mcqn/nfc-st25r3916/README.md

# Vicino NFC/RFID Board

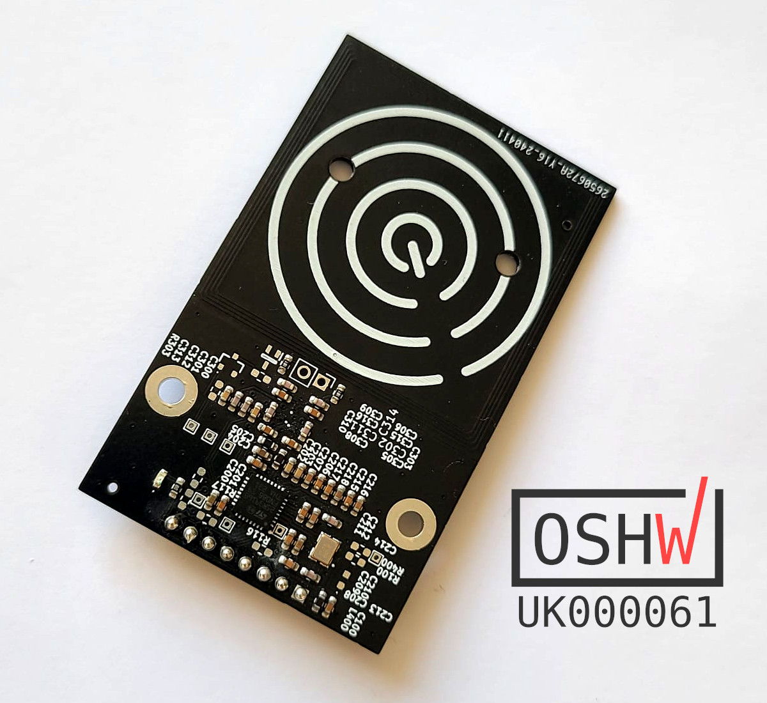
[picture p1: VICINO-Main-OSHW.jpg]
A black rectangular PCB with chips and components clustered in the bottom third. The rest of the board is an antenna, marked with concentric circles of white silkscreen


An RFID/NFC reader using the ST Microelectronics ST25R3916B chip.  Hardware available [from the MCQN Ltd. shop](https://www.tindie.com/products/mcqn_ltd/vicino/).

For using the board see the [Examples.md](Examples.md) page.
