mcqn/nfc-st25r3916/KiCad/cardboard/cardboard_bom.ods

Ref | Qty | Value | Cmp name | Footprint | Description | Mouser 20240116 order | Qty | Vendor links
U200, | 1 | ST25R3916B-AQWT | ST25R3916B-AQWT | QFN50P500X500X100-33N-D | NFC/RFID Tags & Transponders NFC reader for payment, consumer and industrial | https://www.mouser.co.uk/ProductDetail/511-ST25R3916B-AQWT | 5 | https://www.digikey.co.uk/en/products/detail/stmicroelectronics/ST25R3916B-AQWT/16516567
Y200, | 1 | NX3225SA-27.12M-STD-CSR-3 | NX3225SA-27.12M-STD-CSR-3 | Lol_20230821:NX3225SA12000MHZSTDCSR1 | Crystal SMD 3225 27.12MHz | https://www.mouser.co.uk/ProductDetail/344-NX3225SA27.12MST | 5 | https://www.mouser.co.uk/ProductDetail/NDK/NX3225SA-27.12M-STD-CSR-3?qs=w%2Fv1CP2dgqrycwpf4zbGAA%3D%3D | https://uk.farnell.com/samsung-electro-mechanics/cl10a225kq8nnnc/cap-2-2uf-6-3v-mlcc-0603/dp/3013394RL | Re-reel
C100, C207, C210, C212, C216, C218, | 6 | 2u2 | C | Lol_20230821:Lol_0603 | Unpolarized capacitor | https://www.mouser.co.uk/ProductDetail/Samsung-Electro-Mechanics/CL10A225KP8NNNC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 | 100 | https://uk.farnell.com/samsung-electro-mechanics/cl10a225kq8nnnc/cap-2-2uf-6-3v-mlcc-0603/dp/3013394 | https://uk.farnell.com/samsung-electro-mechanics/cl10a105ka8nnnc/cap-1uf-25v-mlcc-0603/dp/3010056
C200, | 1 | 1u | C | Lol_20230821:Lol_0603 | Unpolarized capacitor | https://www.mouser.co.uk/ProductDetail/KEMET/C0603C105K4RACTU?qs=STjISULpmtZNMAZGR4X39Q%3D%3D | 10 | https://uk.farnell.com/samsung-electro-mechanics/cl10a105ka8nnnc/cap-1uf-25v-mlcc-0603/dp/3013382 | https://uk.farnell.com/samsung-electro-mechanics/cl10b103kb8nnnc/cap-0-01uf-50v-mlcc-0603/dp/3010081 | Full reel 4000 £12
C201, C204, C206, C208, C209, C211, C215, C217, | 8 | 10n | C | Lol_20230821:Lol_0603 | Unpolarized capacitor | https://www.mouser.co.uk/ProductDetail/YAGEO/CC0603KRX7R9BB103?qs=AgBp2OyFlx%252BeoRRspw6PJg%3D%3D | 100 | https://uk.farnell.com/samsung-electro-mechanics/cl10b103kb8nnnc/cap-0-01uf-50v-mlcc-0603/dp/3013408
C202, | 1 | 1n | C | Lol_20230821:Lol_0603 | Unpolarized capacitor | https://www.mouser.co.uk/ProductDetail/KEMET/C0603C102J5RACTU?qs=qG1y%252BaZBm0ORyW8zMfKotw%3D%3D | 10 | https://uk.farnell.com/samsung-electro-mechanics/cl10c102jb8nnnc/cap-1000pf-50v-mlcc-0603/dp/3013440
C203, | 1 | 22n | C | Lol_20230821:Lol_0603 | Unpolarized capacitor | https://www.mouser.co.uk/ProductDetail/KEMET/C0603C223K5RACAUTO7411?qs=qbH48L%2FGONQMhVCNVaAS1Q%3D%3D | 10
C205, | 1 | 4u7 | C | Lol_20230821:Lol_0603 | Unpolarized capacitor | https://www.mouser.co.uk/ProductDetail/Samsung-Electro-Mechanics/CL10A475KP8NNNL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 | 10 | https://uk.farnell.com/samsung-electro-mechanics/cl10a225kq8nnnc/cap-2-2uf-6-3v-mlcc-0603/dp/3013394RL | Per order charge
C213, C214, C301, C312, | 4 | 10p | C | Lol_20230821:Lol_0603 | Unpolarized capacitor | https://www.mouser.co.uk/ProductDetail/Vishay-Vitramon/VJ0603A100GXACW1BC?qs=PdD6qrCyjkAydYW8ITawjw%3D%3D | 40 | https://uk.farnell.com/multicomp-pro/mc0603n100f500ct/ceramic-capacitor-10pf-50v-c0g/dp/1710160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 | https://uk.farnell.com/yageo/cc0603grnpo9bn181/cap-180pf-50v-mlcc-0603/dp/3764441RL | https://uk.farnell.com/multicomp-pro/mp0603n181g500ct/cap-180pf-50v-mlcc-0603/dp/4130254RL | https://uk.farnell.com/murata/gcm1885c2a181fa16d/cap-180pf-100v-mlcc-0603/dp/3784624 | https://uk.farnell.com/yageo/cc0603grnpo9bn181/cap-180pf-50v-mlcc-0603/dp/3759598 | https://uk.farnell.com/yageo/cc0603frnpo9bn181/cap-180pf-50v-mlcc-0603/dp/3759566
C305, C308, | 2 | 680p | C | Lol_20230821:Lol_0603 | Unpolarized capacitor | https://www.mouser.co.uk/ProductDetail/Samsung-Electro-Mechanics/CL10C681JB8NFNC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 | 20 | https://uk.farnell.com/murata/gcm1885c2a681fa16d/cap-aec-q200-680pf-100v-mlcc-0603/dp/3581272 | https://www.mouser.co.uk/ProductDetail/Murata-Electronics/LXRW0YV600-054?qs=ds50AKTGxA8D9pWE0AMokg%3D%3D
C302, C314, C311 | 3 | LXRW0YV600-054 | LXRW0YV600-054_Drawn | Lol_20230821:LXRW0YV600054 Handsolder | Trimmer / Variable Capacitors 50VAC 60pF CSP 0.6x0.6mm | https://www.mouser.co.uk/ProductDetail/Murata-Electronics/LXRW0YV600-054?qs=ds50AKTGxA8D9pWE0AMokg%3D%3D | 20 | https://uk.farnell.com/murata/lxrw0yv600-054/variable-capacitor-30-60pf-smd/dp/3052318 | https://uk.farnell.com/walsin/0603n101g500/capacitor-mlcc-100pf-c0g-50v-0603/dp/3790524 | https://uk.farnell.com/yageo/cc0603frnpo9bn101/cap-100pf-50v-mlcc-0603/dp/3759559
L300, L301, L400, | 3 | MLJ1608WR27JT000 | Lol_L | Lol_20230821:Lol_0603 |  | https://www.mouser.co.uk/ProductDetail/TDK/MLJ1608WR27JT000?qs=XFe3dyCRgQjWReJUSn7JRQ%3D%3D | 20 | https://uk.farnell.com/tdk/mlj1608wr27jt000/inductor-270nh-260mhz-shld-0603/dp/3386864?st=MLJ1608WR27JT000 | https://uk.farnell.com/murata/gcm1885c2a681ga16d/cap-aec-q200-680pf-100v-mlcc-0603/dp/3784366RL
LED100, LED101, | 2 | ~ | Lol_LED | MP008285 | LED, Red, SMD, 0603 [1608 Metric], 20 mA, 2.4 V, 638 nm |  |  |  | https://uk.farnell.com/walsin/0603n560g500ct/cap-56pf-50v-mlcc-0603/dp/3881041
R100, R101, | 2 | 1k | Lol_R | Lol_20230821:Lol_0603 | Resistor | https://www.mouser.co.uk/ProductDetail/YAGEO/AC0603FR-071KL | 20 | https://uk.farnell.com/multicomp-pro/mcwf06p1001ftl/res-thick-film-1k-1-0-125w-0603/dp/2694032
J411, | 1 | Conn_01x02_Pin | Conn_01x02_Pin | Connector_PinHeader_2.54mm:PinHeader_1x02_P2.54mm_Vertical | Generic connector, single row, 01x02, script generated |  |  |  | https://uk.farnell.com/vishay/vj0603a470gxacw1bc/cap-47pf-50v-2-c0g-np0-0603/dp/2896392 | https://uk.farnell.com/multicomp/mcmt18n470f100ct/cap-47pf-10v-1-c0g-np0-0603/dp/1856084RL
J412, | 1 | Conn_01x08_Pin | Conn_01x08_Pin | Connector_PinHeader_2.54mm:PinHeader_1x08_P2.54mm_Vertical | Generic connector, single row, 01x08, script generated
YELLOW = Needs to be specified after after antenna measurement
R300, R302, | 2 | 2R4 | Lol_R | Lol_20230821:Lol_0603 | Resistor | https://www.mouser.co.uk/ProductDetail/ROHM-Semiconductor/SDR03EZPJ2R4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 | 20 | https://uk.farnell.com/walsin/wr06w2r40ftl/res-2r4-1-0-1w-0603-thick-film/dp/2668257
C300, C313, | 2 | 180p | C | Lol_20230821:Lol_0603 | Unpolarized capacitor | https://www.mouser.co.uk/ProductDetail/YAGEO/CC0603GRNPO9BN181?qs=7s%252B3O6pAiyAu%252BAHaaNvB1w%3D%3D | 20 | https://uk.farnell.com/walsin/0603n181g500ct/cap-180pf-50v-mlcc-0603/dp/3881033
C303, C310, | 2 | 100p | C | Lol_20230821:Lol_0603 | Unpolarized capacitor | https://www.mouser.co.uk/ProductDetail/KEMET/C0603C101G1HACTU?qs=W0yvOO0ixfHBevHwATrgTQ%3D%3D | 20 | https://uk.farnell.com/walsin/0603n101f500ct/cap-100pf-50v-mlcc-0603/dp/3881026
C306, C309, | 2 | 56p | C | Lol_20230821:Lol_0603 | Unpolarized capacitor | https://www.mouser.co.uk/ProductDetail/Walsin/0603N560F500CT?qs=ZrPdAQfJ6DOrm8xCUHxE5Q%3D%3D | 20 | https://uk.farnell.com/murata/gcm1885c2a560fa16d/cap-aec-q200-56pf-100v-mlcc-0603/dp/3581267
C315, C316, | 2 | 82p | C | Lol_20230821:Lol_0603 | Unpolarized capacitor | https://www.mouser.co.uk/ProductDetail/Walsin/HH18N820G500CT?qs=ZrPdAQfJ6DO5GXvCW23E%252Bw%3D%3D | 20 | https://uk.farnell.com/yageo/cc0603frnpo9bn820/cap-82pf-50v-mlcc-0603/dp/3764431
RED = Do Not Fit
D300, | 1 | BAV70W-7-F | BAV70W-7-F | SOT65P210X100-3N | Diodes Inc 75V 300mA, Dual Silicon Junction Diode, 3-Pin SOT-323 BAV70W-7-F |  |  | https://uk.farnell.com/diodes-inc/bav70w-7-f/diode-small-signal-75v-0-3a-sot/dp/3127228?st=bav70w-7-f | https://www.mouser.co.uk/ProductDetail/Diodes-Incorporated/BAV70W-7-F?qs=1PNjYYN%2FHq3Y%2FR1jDefEWg%3D%3D
J300_1, J300_2, | 2 | Conn_01x01_Female | TestPoint_TH_Square | Lol_20230821:TestPoint_THTPad_1.0x1.0mm_Drill0.5mm | Generic connector, single row, 01x01, script generated (kicad-library-utils/schlib/autogen/connector/)
J400, J401, J402, J403, J406, J407, J408, | 7 | Conn_01x01_Female | TestPoint_TH_Square | Lol_20230821:TestPoint_THTPad_1.0x1.0mm_Drill0.5mm | Generic connector, single row, 01x01, script generated (kicad-library-utils/schlib/autogen/connector/)
P200, P202, | 2 | U.FL-R-SMT-1_10_ | Lol_U.FL | Lol_20230821:U.FL-R-SMT-1_10_ | UFL SMT PCB receptable,DC-6GHz Hirose Straight 50 Surface Mount UFL Connector, Receptacle, Solder Termination Coaxial | https://www.mouser.co.uk/ProductDetail/Hirose-Connector/U.FL-R-SMT-110?qs=kL1ClTr6oBoOdtqlGQpQrQ%3D%3D | 3 | https://uk.farnell.com/hirose-hrs/u-fl-r-smt-1-10/rf-coaxial-u-fl-straight-jack/dp/1688077
Q300, | 1 | NX3008NBK,215 | NX3008NBK,215 | NX3008NBK215 | NEXPERIA - NX3008NBK,215 - MOSFET Transistor, Trench, N Channel, 400 mA, 30 V, 1 ohm, 4.5 V, 900 mV |  |  | https://uk.farnell.com/nexperia/nx3008nbk-215/mosfet-n-ch-30v-400ma-sot23/dp/2069541?st=nx3008nbk
R116, R117, | 2 | 1k8 NF | Lol_R | Lol_20230821:Lol_0603 | Resistor |  |  | https://uk.farnell.com/te-connectivity/crgh0603f1k8/res-1k8-1-0-2w-0603-thick-film/dp/2332006
R204, | 1 | NF | Lol_R | Lol_20230821:Lol_0603 | Resistor |  |  |  | https://www.mouser.co.uk/ProductDetail/STMicroelectronics/ST25R3916B-AQWT?qs=Znm5pLBrcAK6gbJpvnT4Gw%3D%3D | https://uk.farnell.com/stmicroelectronics/st25r3916b-aqwt/rfid-read-write-27-12mhz-vfqfpn/dp/4067510
R205, R400, | 2 | NetTie_2 | TestPoint_Link_0603 | Lol_20230821:Lol_0603_tie | Breakin test point 0603 |  |  |  | https://uk.rs-online.com/web/p/crystal-units/1847880 | https://jlcpcb.com/partdetail/Ndk-NX3225SA_27_12M_STD_CSR3/C1987076 |  |  |  | https://www.mouser.co.uk/ProductDetail/NDK/NX3225SA-27.12M-STD-CSR-3?qs=w%2Fv1CP2dgqrycwpf4zbGAA%3D%3D
R301, | 1 | 100R | Lol_R | Lol_20230821:Lol_0603 | Resistor |  |  | https://uk.farnell.com/multicomp/mcwf06p1000ftl/res-100r-1-0-125w-0603-thick-film/dp/2694031
R303, | 1 | 47k | Lol_R | Lol_20230821:Lol_0603 | Resistor |  |  | https://uk.farnell.com/multicomp/mcwr06x4702ftl/res-47k-1-0-1w-thick-film/dp/2447376
H2,H1 | 2 | MountingHole_Pad | MountingHole_3.2mm_M3_Pad
H4,H3 | 2 | MountingHole NC | MountingHole_3.2mm_M3_Pad NPTH
