mcqn/nfc-st25r3916/tuning-test-data/39pF-1R5-33pF-acrylic-enclosure-tuning-scan.csv

aat_a | aat_b | amplitude
0 | 0 | 99
0 | 8 | 99
0 | 16 | 100
0 | 24 | 100
0 | 32 | 99
0 | 40 | 99
0 | 48 | 98
0 | 56 | 97
0 | 64 | 96
0 | 72 | 94
0 | 80 | 93
0 | 88 | 90
0 | 96 | 88
0 | 104 | 85
0 | 112 | 82
0 | 120 | 79
0 | 128 | 77
0 | 136 | 74
0 | 144 | 71
0 | 152 | 68
0 | 160 | 65
0 | 168 | 63
0 | 176 | 60
0 | 184 | 58
0 | 192 | 56
0 | 200 | 54
0 | 208 | 52
0 | 216 | 50
0 | 224 | 49
0 | 232 | 47
0 | 240 | 46
0 | 248 | 44
8 | 0 | 100
8 | 8 | 100
8 | 16 | 100
8 | 24 | 100
8 | 32 | 100
8 | 40 | 100
8 | 48 | 99
8 | 56 | 98
8 | 64 | 97
8 | 72 | 95
8 | 80 | 93
8 | 88 | 91
8 | 96 | 88
8 | 104 | 86
8 | 112 | 83
8 | 120 | 80
8 | 128 | 77
8 | 136 | 74
8 | 144 | 72
8 | 152 | 69
8 | 160 | 66
8 | 168 | 64
8 | 176 | 61
8 | 184 | 59
8 | 192 | 57
8 | 200 | 55
8 | 208 | 53
8 | 216 | 51
8 | 224 | 50
8 | 232 | 48
8 | 240 | 47
8 | 248 | 45
16 | 0 | 100
16 | 8 | 100
16 | 16 | 101
16 | 24 | 101
16 | 32 | 101
16 | 40 | 101
16 | 48 | 100
16 | 56 | 99
16 | 64 | 98
16 | 72 | 96
16 | 80 | 94
16 | 88 | 92
16 | 96 | 90
16 | 104 | 87
16 | 112 | 85
16 | 120 | 82
16 | 128 | 79
16 | 136 | 76
16 | 144 | 73
16 | 152 | 70
16 | 160 | 68
16 | 168 | 65
16 | 176 | 63
16 | 184 | 60
16 | 192 | 58
16 | 200 | 56
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
