mcqn/nfc-st25r3916/tuning-test-data/39pF-1R5-33pF-free-air-tuning-scan.csv

aat_a | aat_b | amplitude
0 | 0 | 98
0 | 8 | 98
0 | 16 | 98
0 | 24 | 98
0 | 32 | 98
0 | 40 | 98
0 | 48 | 97
0 | 56 | 96
0 | 64 | 95
0 | 72 | 93
0 | 80 | 91
0 | 88 | 89
0 | 96 | 86
0 | 104 | 84
0 | 112 | 81
0 | 120 | 78
0 | 128 | 75
0 | 136 | 72
0 | 144 | 69
0 | 152 | 67
0 | 160 | 64
0 | 168 | 62
0 | 176 | 59
0 | 184 | 57
0 | 192 | 55
0 | 200 | 53
0 | 208 | 51
0 | 216 | 50
0 | 224 | 48
0 | 232 | 46
0 | 240 | 45
0 | 248 | 44
8 | 0 | 99
8 | 8 | 99
8 | 16 | 99
8 | 24 | 99
8 | 32 | 99
8 | 40 | 99
8 | 48 | 98
8 | 56 | 97
8 | 64 | 95
8 | 72 | 94
8 | 80 | 92
8 | 88 | 90
8 | 96 | 87
8 | 104 | 85
8 | 112 | 82
8 | 120 | 79
8 | 128 | 76
8 | 136 | 73
8 | 144 | 70
8 | 152 | 68
8 | 160 | 65
8 | 168 | 63
8 | 176 | 61
8 | 184 | 58
8 | 192 | 56
8 | 200 | 54
8 | 208 | 52
8 | 216 | 51
8 | 224 | 49
8 | 232 | 47
8 | 240 | 46
8 | 248 | 45
16 | 0 | 99
16 | 8 | 99
16 | 16 | 100
16 | 24 | 100
16 | 32 | 100
16 | 40 | 100
16 | 48 | 99
16 | 56 | 98
16 | 64 | 97
16 | 72 | 95
16 | 80 | 93
16 | 88 | 91
16 | 96 | 89
16 | 104 | 86
16 | 112 | 83
16 | 120 | 80
16 | 128 | 78
16 | 136 | 75
16 | 144 | 72
16 | 152 | 69
16 | 160 | 67
16 | 168 | 64
16 | 176 | 62
16 | 184 | 60
16 | 192 | 58
16 | 200 | 55
16 | 208 | 54
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
