mcqn/nfc-st25r3916/tuning-test-data/39pF-1R5-acrylic-enclosure-tuning-scan.csv

aat_a | aat_b | amplitude
0 | 0 | 91
0 | 8 | 91
0 | 16 | 92
0 | 24 | 93
0 | 32 | 94
0 | 40 | 96
0 | 48 | 97
0 | 56 | 98
0 | 64 | 99
0 | 72 | 100
0 | 80 | 101
0 | 88 | 101
0 | 96 | 102
0 | 104 | 102
0 | 112 | 102
0 | 120 | 101
0 | 128 | 101
0 | 136 | 100
0 | 144 | 98
0 | 152 | 96
0 | 160 | 94
0 | 168 | 90
0 | 176 | 86
0 | 184 | 82
0 | 192 | 78
0 | 200 | 74
0 | 208 | 71
0 | 216 | 67
0 | 224 | 65
0 | 232 | 62
0 | 240 | 60
0 | 248 | 57
8 | 0 | 90
8 | 8 | 91
8 | 16 | 92
8 | 24 | 93
8 | 32 | 94
8 | 40 | 96
8 | 48 | 97
8 | 56 | 98
8 | 64 | 99
8 | 72 | 100
8 | 80 | 101
8 | 88 | 101
8 | 96 | 102
8 | 104 | 102
8 | 112 | 102
8 | 120 | 101
8 | 128 | 101
8 | 136 | 100
8 | 144 | 98
8 | 152 | 96
8 | 160 | 94
8 | 168 | 90
8 | 176 | 87
8 | 184 | 83
8 | 192 | 79
8 | 200 | 75
8 | 208 | 71
8 | 216 | 68
8 | 224 | 65
8 | 232 | 62
8 | 240 | 60
8 | 248 | 58
16 | 0 | 90
16 | 8 | 90
16 | 16 | 91
16 | 24 | 93
16 | 32 | 94
16 | 40 | 95
16 | 48 | 96
16 | 56 | 98
16 | 64 | 99
16 | 72 | 100
16 | 80 | 100
16 | 88 | 101
16 | 96 | 101
16 | 104 | 102
16 | 112 | 102
16 | 120 | 101
16 | 128 | 101
16 | 136 | 100
16 | 144 | 99
16 | 152 | 97
16 | 160 | 94
16 | 168 | 91
16 | 176 | 87
16 | 184 | 83
16 | 192 | 79
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
