mcqn/nfc-st25r3916/tuning-test-data/39pF-1R5-free-air-tuning-scan.csv

aat_a | aat_b | amplitude
0 | 0 | 89
0 | 8 | 90
0 | 16 | 91
0 | 24 | 92
0 | 32 | 93
0 | 40 | 95
0 | 48 | 96
0 | 56 | 97
0 | 64 | 98
0 | 72 | 99
0 | 80 | 100
0 | 88 | 101
0 | 96 | 101
0 | 104 | 101
0 | 112 | 101
0 | 120 | 101
0 | 128 | 100
0 | 136 | 99
0 | 144 | 97
0 | 152 | 95
0 | 160 | 92
0 | 168 | 88
0 | 176 | 84
0 | 184 | 80
0 | 192 | 76
0 | 200 | 72
0 | 208 | 69
0 | 216 | 66
0 | 224 | 63
0 | 232 | 61
0 | 240 | 58
0 | 248 | 56
8 | 0 | 89
8 | 8 | 90
8 | 16 | 91
8 | 24 | 92
8 | 32 | 93
8 | 40 | 95
8 | 48 | 96
8 | 56 | 97
8 | 64 | 98
8 | 72 | 99
8 | 80 | 100
8 | 88 | 101
8 | 96 | 101
8 | 104 | 101
8 | 112 | 101
8 | 120 | 101
8 | 128 | 100
8 | 136 | 99
8 | 144 | 97
8 | 152 | 95
8 | 160 | 92
8 | 168 | 88
8 | 176 | 84
8 | 184 | 80
8 | 192 | 76
8 | 200 | 73
8 | 208 | 69
8 | 216 | 66
8 | 224 | 64
8 | 232 | 61
8 | 240 | 59
8 | 248 | 57
16 | 0 | 88
16 | 8 | 89
16 | 16 | 90
16 | 24 | 92
16 | 32 | 93
16 | 40 | 94
16 | 48 | 96
16 | 56 | 97
16 | 64 | 98
16 | 72 | 99
16 | 80 | 100
16 | 88 | 101
16 | 96 | 101
16 | 104 | 101
16 | 112 | 101
16 | 120 | 101
16 | 128 | 100
16 | 136 | 99
16 | 144 | 97
16 | 152 | 95
16 | 160 | 92
16 | 168 | 88
16 | 176 | 85
16 | 184 | 81
16 | 192 | 77
16 | 200 | 73
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
