mcqn/nfc-st25r3916/tuning-test-data/47pF-1R5-33pF-acrylic-enclosure-tuning-scan.csv

aat_a | aat_b | amplitude
0 | 0 | 55
0 | 8 | 56
0 | 16 | 57
0 | 24 | 58
0 | 32 | 60
0 | 40 | 63
0 | 48 | 66
0 | 56 | 70
0 | 64 | 75
0 | 72 | 81
0 | 80 | 88
0 | 88 | 94
0 | 96 | 98
0 | 104 | 102
0 | 112 | 104
0 | 120 | 105
0 | 128 | 104
0 | 136 | 103
0 | 144 | 101
0 | 152 | 99
0 | 160 | 96
0 | 168 | 93
0 | 176 | 91
0 | 184 | 87
0 | 192 | 85
0 | 200 | 81
0 | 208 | 79
0 | 216 | 75
0 | 224 | 73
0 | 232 | 70
0 | 240 | 68
0 | 248 | 65
8 | 0 | 54
8 | 8 | 55
8 | 16 | 57
8 | 24 | 58
8 | 32 | 60
8 | 40 | 63
8 | 48 | 66
8 | 56 | 70
8 | 64 | 75
8 | 72 | 81
8 | 80 | 88
8 | 88 | 94
8 | 96 | 100
8 | 104 | 103
8 | 112 | 105
8 | 120 | 105
8 | 128 | 105
8 | 136 | 104
8 | 144 | 102
8 | 152 | 100
8 | 160 | 97
8 | 168 | 95
8 | 176 | 92
8 | 184 | 89
8 | 192 | 86
8 | 200 | 83
8 | 208 | 80
8 | 216 | 77
8 | 224 | 74
8 | 232 | 72
8 | 240 | 69
8 | 248 | 67
16 | 0 | 54
16 | 8 | 55
16 | 16 | 56
16 | 24 | 58
16 | 32 | 60
16 | 40 | 62
16 | 48 | 66
16 | 56 | 69
16 | 64 | 74
16 | 72 | 80
16 | 80 | 86
16 | 88 | 93
16 | 96 | 99
16 | 104 | 103
16 | 112 | 105
16 | 120 | 106
16 | 128 | 106
16 | 136 | 105
16 | 144 | 103
16 | 152 | 101
16 | 160 | 99
16 | 168 | 96
16 | 176 | 93
16 | 184 | 90
16 | 192 | 87
16 | 200 | 85
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
