mcqn/nfc-st25r3916/tuning-test-data/47pF-1R5-33pF-free-air-tuning-scan.csv

aat_a | aat_b | amplitude
0 | 0 | 48
0 | 8 | 48
0 | 16 | 49
0 | 24 | 49
0 | 32 | 50
0 | 40 | 52
0 | 48 | 53
0 | 56 | 55
0 | 64 | 57
0 | 72 | 60
0 | 80 | 62
0 | 88 | 65
0 | 96 | 68
0 | 104 | 71
0 | 112 | 74
0 | 120 | 78
0 | 128 | 81
0 | 136 | 84
0 | 144 | 87
0 | 152 | 90
0 | 160 | 92
0 | 168 | 95
0 | 176 | 97
0 | 184 | 98
0 | 192 | 100
0 | 200 | 101
0 | 208 | 102
0 | 216 | 103
0 | 224 | 104
0 | 232 | 104
0 | 240 | 105
0 | 248 | 105
8 | 0 | 47
8 | 8 | 48
8 | 16 | 48
8 | 24 | 49
8 | 32 | 50
8 | 40 | 52
8 | 48 | 53
8 | 56 | 55
8 | 64 | 57
8 | 72 | 60
8 | 80 | 62
8 | 88 | 65
8 | 96 | 68
8 | 104 | 71
8 | 112 | 74
8 | 120 | 78
8 | 128 | 81
8 | 136 | 84
8 | 144 | 88
8 | 152 | 90
8 | 160 | 93
8 | 168 | 95
8 | 176 | 97
8 | 184 | 99
8 | 192 | 100
8 | 200 | 101
8 | 208 | 102
8 | 216 | 103
8 | 224 | 104
8 | 232 | 104
8 | 240 | 105
8 | 248 | 105
16 | 0 | 47
16 | 8 | 48
16 | 16 | 48
16 | 24 | 49
16 | 32 | 50
16 | 40 | 51
16 | 48 | 53
16 | 56 | 55
16 | 64 | 57
16 | 72 | 59
16 | 80 | 62
16 | 88 | 64
16 | 96 | 67
16 | 104 | 71
16 | 112 | 74
16 | 120 | 77
16 | 128 | 81
16 | 136 | 84
16 | 144 | 87
16 | 152 | 90
16 | 160 | 92
16 | 168 | 95
16 | 176 | 97
16 | 184 | 98
16 | 192 | 100
16 | 200 | 101
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
