mcqn/nfc-st25r3916/tuning-test-data/39pF-1R5-33pF-acrylic-enclosure-tuning-scan.png

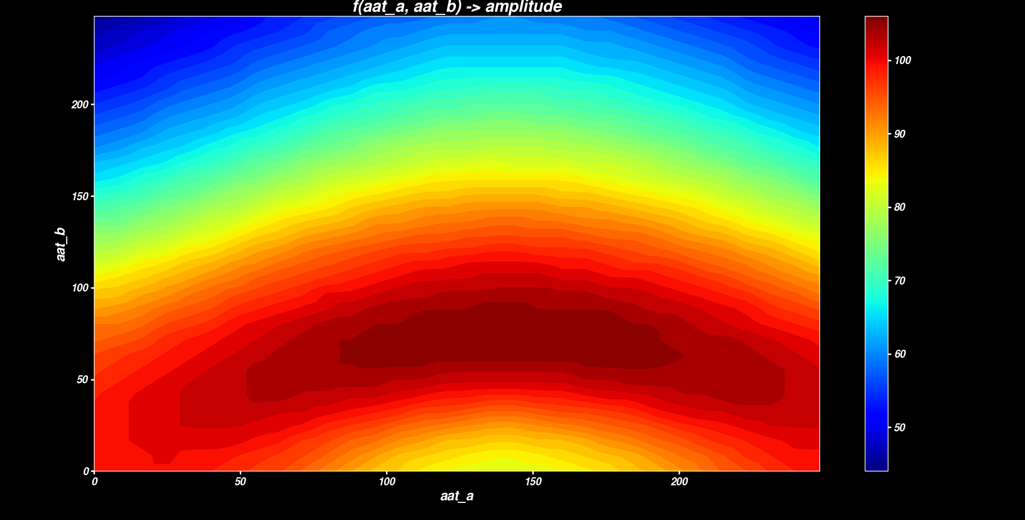
tuning-test-data/39pF-1R5-33pF-acrylic-enclosure-tuning-scan.png
