mcqn/nfc-st25r3916/tuning-test-data/47pF-1R5-33pF-free-air-tuning-scan.png

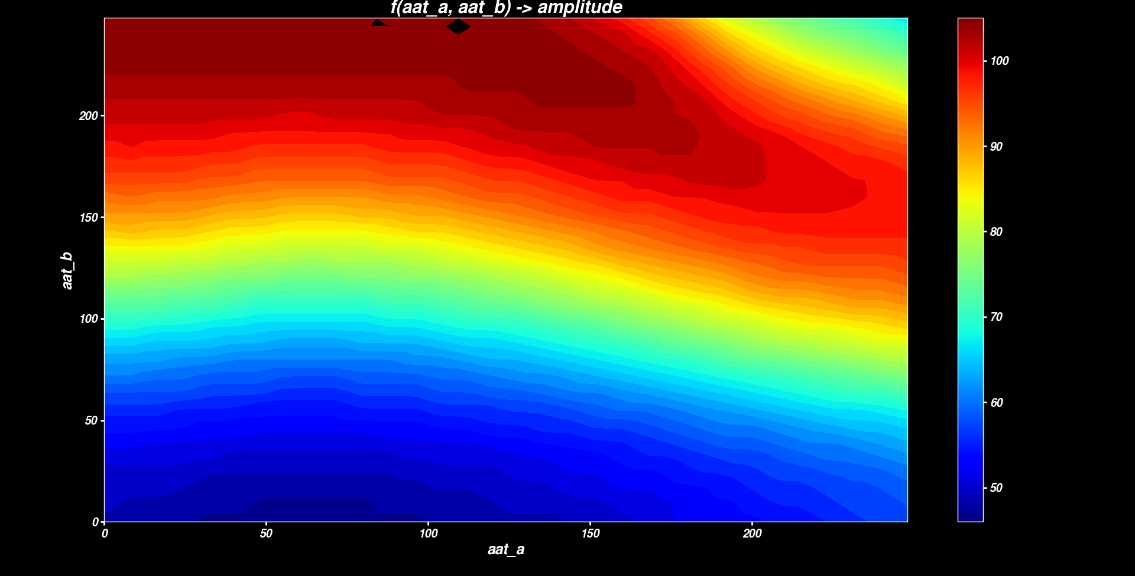
tuning-test-data/47pF-1R5-33pF-free-air-tuning-scan.png
