mcqn/nfc-st25r3916/tuning-test-data/47pF-2R4-acrylic-enclosure-tuning-scan.png

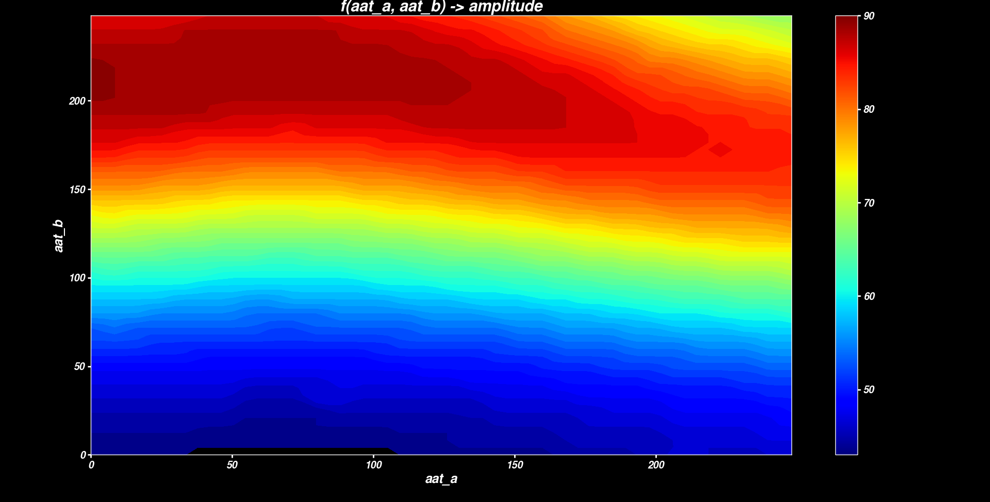
tuning-test-data/47pF-2R4-acrylic-enclosure-tuning-scan.png
