mcqn/nfc-st25r3916/(threads)

Thread 1 (2023-11-29):

Initial design of reader

amcewen, 2023-11-29:
The initial use of this reader will be as a replacement for the RC522 reader currently used by [Museum in a Box](https://museuminabox.org).

Key features:
* An LED on the top, which illuminates when a card is detected.  This will need to be controlled by whatever is connected to the reader, so effectively it's an LED controlled by a GPIO on the 8-way connector.
* An 8-way 0.1" pitch header on the underside for connection to the main board.  Through-hole I think.
* 4 mounting holes (3.2mm diameter)

Here's a rough guide to where things sit above the Museum in a Box PCB:

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

For the 8-way header, from left-to-right as seen in that image above (the red component footprint is the surface-mount 0.1" header) it would be good if we can keep to this pin-out: `3V3`, `IRQ`, `GND`, `LED`, `MISO`, `MOSI`, `SCLK`, `CS`

huffeec, 2024-03-14:
Closed with 4cfd301

Closed 2024-03-14.

Thread 4 (2024-01-31):

Initial bring-up and tuning

amcewen, 2024-01-31:
With a couple of boards fabbed we're onto bring-up and tuning of the antenna.

Initial key capacitor and resistor values are:
* C303 = C310 = 22pF
* C306 = C309 = 15pF
* C300 = C313 = 220pF
* C315 = C316 = 150pF
* R300 = R302 = 2R4

huffeec, 2024-03-14:
Closed with 4cfd301

Closed 2024-03-14.

Thread 6 (2024-03-13):

Apply for OSHW certification

huffeec, 2024-03-13:
Follow the process used in the [My Baby's got LED application](https://github.com/mcqn/my-babys-got-led/issues/9) to receive OSHW registration for this board.

My Baby's got LED is licenced as [CERN-OHL-S v2.0 ](https://cern-ohl.web.cern.ch/) is this applicable to this hardware too?

The libraries referenced in the documentation are covered by [STMicroelectronics](https://github.com/mcqn/NFC-RFAL/blob/main/LICENSE) but are not software included in this application. I think we are applying as 'No software' here?

The documentation for MBGL is licenced as [[CC BY-SA 4.0](http://creativecommons.org/licenses/by-sa/4.0/)]

#### We will need a name, version number and description for the application.

Eg "An RFID/NFC reader using the ST Microelectronics ST25R3916 chip. The board gives access via a header to power/gnd, four SPI pins, irq and a status led. The development and documentation for the board is available on github, and the board is manufactured by mcqn and sold on Tindie."

Should this include more detail, eg of modes available?

Tasks required to submit application to OSHW

- [x] Assign ibal number and add to catalogue
- [x] Confirm licence and add to repo
- [x] Decide on name and complete description

amcewen, 2024-03-14:
I've made the repo public.

We should put the name somewhere on the silkscreen on the board too.

huffeec, 2024-03-14:
Current silkscreen for the back of the board.
All the right information (I think), although not necessarily in the right order (or font)

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

huffeec, 2024-03-14:
##### OSHW form details (draft)

SECTION 1 OF 4
Same as My Baby's got LED

SECTION 2 OF 4
This part of the form asks for information about the project you wish to certify. Information submitted here will appear on your project’s profile listing.

Project name: Vicino NFC/RFID board
Project version: r20240314
Have you previously registered a version(s) of your project with OSHWA? No
Project description: An RFID/NFC reader using the ST Microelectronics ST25R3916 chip. The board gives access via a header to power/gnd, four SPI pins, irq and a status led. The development and documentation for the board is available on github, and the board is manufactured by mcqn and sold on Tindie.

Project website: mcqn.com/ibal243
Primary Project Type: Electronics
Additional Project Types:  Electronics,
Project Keywords: NFC, RFID

Where can the documentation be found for your project?: https://github.com/mcqn/nfc-st25r3916/blob/main/Examples.md

Does your project incorporate or build upon other open projects that are not currently certified by OSHWA? If so, use this space to cite those projects N/A

SECTION 3 OF 4
This part of the form asks for information about your project’s licensing. In order to qualify for OSHWA certification, you must have chosen an open source license for your hardware, your software (if any), and your documentation. Your licenses for each of these elements will appear on your project’s profile listing.

What license is your project's hardware licensed under? CERN
What license is your project's software licensed under? No Software **
What license is your project's documentation licensed under? CC BY-SA

YES x9

SECTION 4 of 4
As My Baby's got LED

** As much as I understand it I think the ST Microelectronics licence prohibits us including it here?
>
> 5. No use, reproduction or redistribution of this software package may be done in any manner that would subject
> this software package to any Open Source Terms (as defined below).
[https://github.com/stm32duino/ST25R3916/blob/main/LICENSE](https://github.com/stm32duino/ST25R3916/blob/main/LICENSE)

huffeec, 2024-03-20:
> Your application us now under review by the OSHWA team. In most cases this review is completed in less than two weeks. Once it is complete you will be notified at the email address you provided in your application. If the team has questions they will reach out to you directly at the same email address. In the meantime, if you have any questions or concerns, please do not hesitate to contact us at [certification@oshwa.org](mailto:certification@oshwa.org).

amcewen, 2024-04-21:
The sixty-first UK device certified:

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

Closed 2024-04-21.

Thread 7 (2024-03-13):

Add pin descriptors for the header to the silkscreen

huffeec, 2024-03-13:
Before we put these on sale the pin names need to be added to the silkscreen.
Along with the OSHW logo.

huffeec, 2024-03-14:
Closed with 4cfd301

Closed 2024-03-14.

Thread 10 (2025-04-30):

Always same amplitude value

rego21, 2025-04-30:
Hi,

Sorry to contact you in an issue but could not found an informal channel to talk.

First of all great work and thanks for this open source board!

As a hobby I decided to print your board and give it a try with an NRF52840 DK. The board seems to be responding as expected to the SPI commands, however it seems I'm not able to detect any card. So and since I have a ESP32 dev kit around I decided to try your code examples, mainly the antenna tuning. And when I run the Full amplitude scan for AAT_B and AAT_A, the value I'm getting for the amplitude its always 30-31. When I approach a card, I can see it drop to 21-29 (depending of AAT B and A).

Is this expected, the board could be damaged or Im missing something (a component for the tuning or a FW step that I probably have to do) ?

Thank you @amcewen  @huffeec

rego21, 2025-05-01:
Hey,

Board was damaged, tested a new one and its working!

thank you!

Closed 2025-05-01.
