mcqn/nfc-st25r3916/(commit log)

2023-12-15 Add notes on wiring to a couple of ESP32 boards, and rough-and-ready example code. Part of #3
2024-01-08 Improved layout to optimize RFO & RFI symmetry.
    [cardboard.kicad_pcb, cardboard.kicad_sch]
2024-01-11 Circuitry section compacted. RFID symmetry improved.
    [cardboard.kicad_pcb, cardboard.kicad_sch]
2024-01-12 Compressed components in y-direction to move centre of RFID area towards centre of box.
    [cardboard.kicad_pcb, cardboard.kicad_sch]
2024-01-13 Added BoM indicating known values and those to be measured
    [cardboard.kicad_sch, cardboard_bom.ods]
2024-01-15 Removed RJ45. Applied OCD prinicples to LED position.
    [cardboard-B_Cu.gbl, cardboard-B_Mask.gbs, cardboard-B_Paste.gbp, cardboard-B_Silkscreen.gbo, cardboard-Edge_Cuts.gm1, cardboard-F_Cu.gtl, cardboard-F_Mask.gts, cardboard-F_Paste.gtp]
2024-01-17 Cleaned the BoM
    [cardboard.csv, cardboard_bom.ods]
2024-01-22 Swapped labels for c312 and c313 on silkscreen
2024-02-03 Add Arduino sketch to help with antenna tuning. Part of #4
2024-02-03 Fix inline image in antenna tuning example. Part of #4
2024-02-04 Adding test data for the initial antenna tuning tests.
    [47pF-2R4-acrylic-enclosure-tuning-scan.csv, 47pF-2R4-free-air-tuning-scan.csv, 47pF-full-tuning-scan.csv]
2024-02-04 Add test scan results for 1R5 resistor change. Part of #4
    [47pF-1R5-acrylic-enclosure-tuning-scan.csv, 47pF-1R5-free-air-tuning-scan.csv]
2024-02-04 Further tuning tests with varying capacitor values for `C306`/`C309` and `C303`/`C310`. Part of #4
    [39pF-1R5-33pF-acrylic-enclosure-tuning-scan.csv, 39pF-1R5-33pF-free-air-tuning-scan.csv, 39pF-1R5-acrylic-enclosure-tuning-scan.csv, 39pF-1R5-free-air-tuning-scan.csv, 47pF-1R5-33pF-acrylic-enclosure-tuning-scan.csv, 47pF-1R5-33pF-free-air-tuning-scan.csv]
2024-02-05 Add silkscreen artwork for the "tag target" on the front of the board. Part of #5
2024-02-05 Update component values in schematic and address silkscreen from #5
    [cardboard.kicad_sch]
2024-02-05 Updated varicap footprint to datasheet, marked red list as DNP
    [cardboard.kicad_sch]
2024-02-18 Add basic example to write a couple of NDEF records to a tag. Part of #3
2024-03-14 Added name and pin descriptions to silk screen, created BOM and /production files for European circuits
    [cardboard.csv, cardboard.kicad_sch, designators.csv, positions.csv]
2024-04-08 Added OSHW number to back silkscreen
2024-04-08 Add oshw logo kicad7
2024-04-08 Revert "Added OSHW number to back silkscreen"
    This reverts commit c406a9f30d0b79f217c325d07f6a273b83436d3f.
2024-04-08 Added OSHW logo to back silkscreen kicad v7
2024-08-21 Fixed silkscreen bug on varicaps for c302, c311, c314
    [cardboard.kicad_sch]
2026-01-07 Print out range of the antenna readings in the tuning example
